cmautner/LED-Cube/Discodelic.png

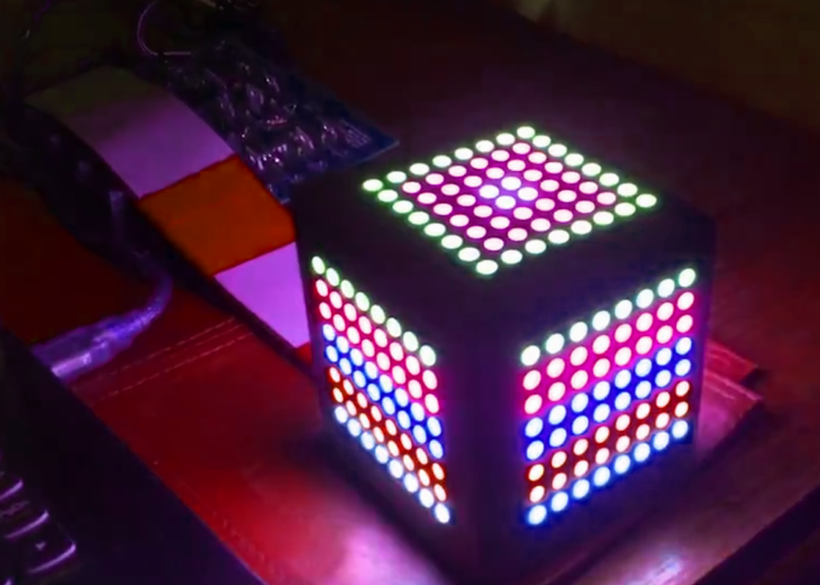
Discodelic.png
