cmautner/LED-Cube/(list of files, drawings)

Other design files:
hardware/LED breakout board.dsn
