cmautner/LED-Cube/hardware/LED breakout board.kicad_pcb

## KiCad design hardware/LED breakout board.kicad_pcb (2016-05-03)

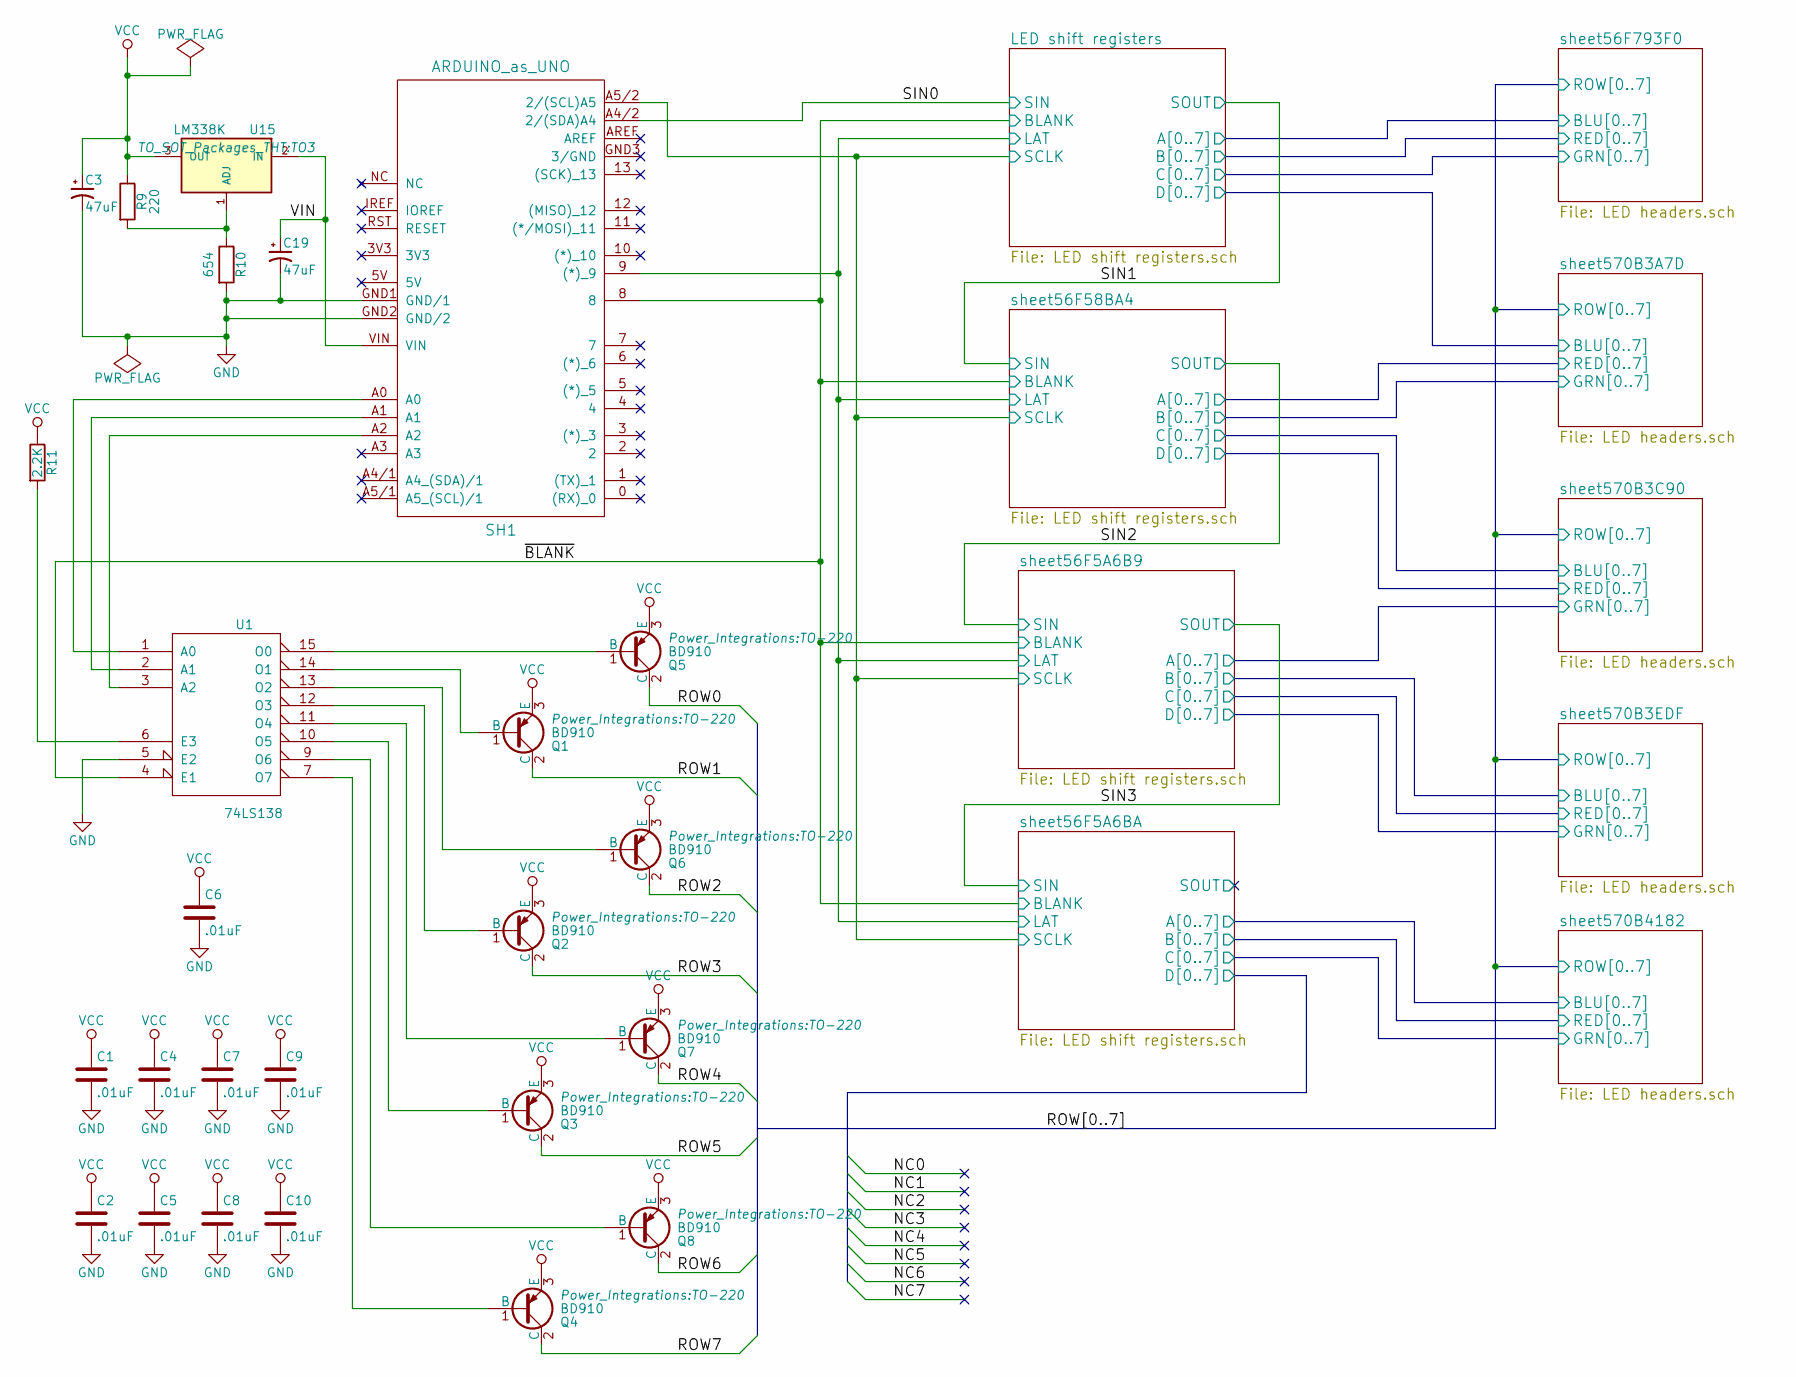
[picture p2: schematic LED breakout board.sch]

Parts:
C1, C2, C4, C5, C6, C7, C8, C9, C10: .01uF; C_Disc_D3_P2.5
C3, C19: 47uF; C_Rect_L7_W3.5_P5
Q1, Q2, Q3, Q4, Q5, Q6, Q7, Q8: BD910; TO-220
R9: 220; Resistor_Horizontal_RM10mm
R10: 654; Resistor_Horizontal_RM10mm
R11: 2.2K; Resistor_Horizontal_RM10mm
SH1: ARDUINO_as_UNO; ARDUINO_as_UNO_R3
U1: 74LS138; DIP-16_W7.62mm
U15: LM338K; TO3

Connections:
/LED shift registers/BLANK: SH1.8, U1.4 (E1); also elsewhere on the board
/LED shift registers/LAT: SH1.9 ((*)_9); also elsewhere on the board
/LED shift registers/SCLK: SH1.A5/2 (2/(SCL)A5); also elsewhere on the board
/LED shift registers/SIN: SH1.A4/2 (2/(SDA)A4); also elsewhere on the board
/ROW0: Q5.2 (C); also elsewhere on the board
/ROW1: Q1.2 (C); also elsewhere on the board
/ROW2: Q6.2 (C); also elsewhere on the board
/ROW3: Q2.2 (C); also elsewhere on the board
/ROW4: Q7.2 (C); also elsewhere on the board
/ROW5: Q3.2 (C); also elsewhere on the board
/ROW6: Q8.2 (C); also elsewhere on the board
/ROW7: Q4.2 (C); also elsewhere on the board
/VIN: C19.1, SH1.VIN, U15.2 (IN)
GND: C1.2, C2.2, C3.2, C4.2, C5.2, C6.2, C7.2, C8.2, C9.2, C10.2, C19.2, R10.2, SH1.GND1 (GND/1), SH1.GND2 (GND/2), U1.5 (E2), U1.8 (GND); also elsewhere on the board
unnamed: Q1.1 (B), U1.14 (O1)
unnamed: Q2.1 (B), U1.12 (O3)
unnamed: Q3.1 (B), U1.10 (O5)
unnamed: Q4.1 (B), U1.7 (O7)
unnamed: Q5.1 (B), U1.15 (O0)
unnamed: Q6.1 (B), U1.13 (O2)
unnamed: Q7.1 (B), U1.11 (O4)
unnamed: Q8.1 (B), U1.9 (O6)
unnamed: R9.2, R10.1, U15.1 (ADJ)
unnamed: R11.2, U1.6 (E3)
unnamed: SH1.A0, U1.1 (A0)
unnamed: SH1.A1, U1.2 (A1)
unnamed: SH1.A2, U1.3 (A2)
VCC: C1.1, C2.1, C3.1, C4.1, C5.1, C6.1, C7.1, C8.1, C9.1, C10.1, Q1.3 (E), Q2.3 (E), Q3.3 (E), Q4.3 (E), Q5.3 (E), Q6.3 (E), Q7.3 (E), Q8.3 (E), R9.1, R11.1, U1.16 (VCC), U15.3 (OUT); also elsewhere on the board

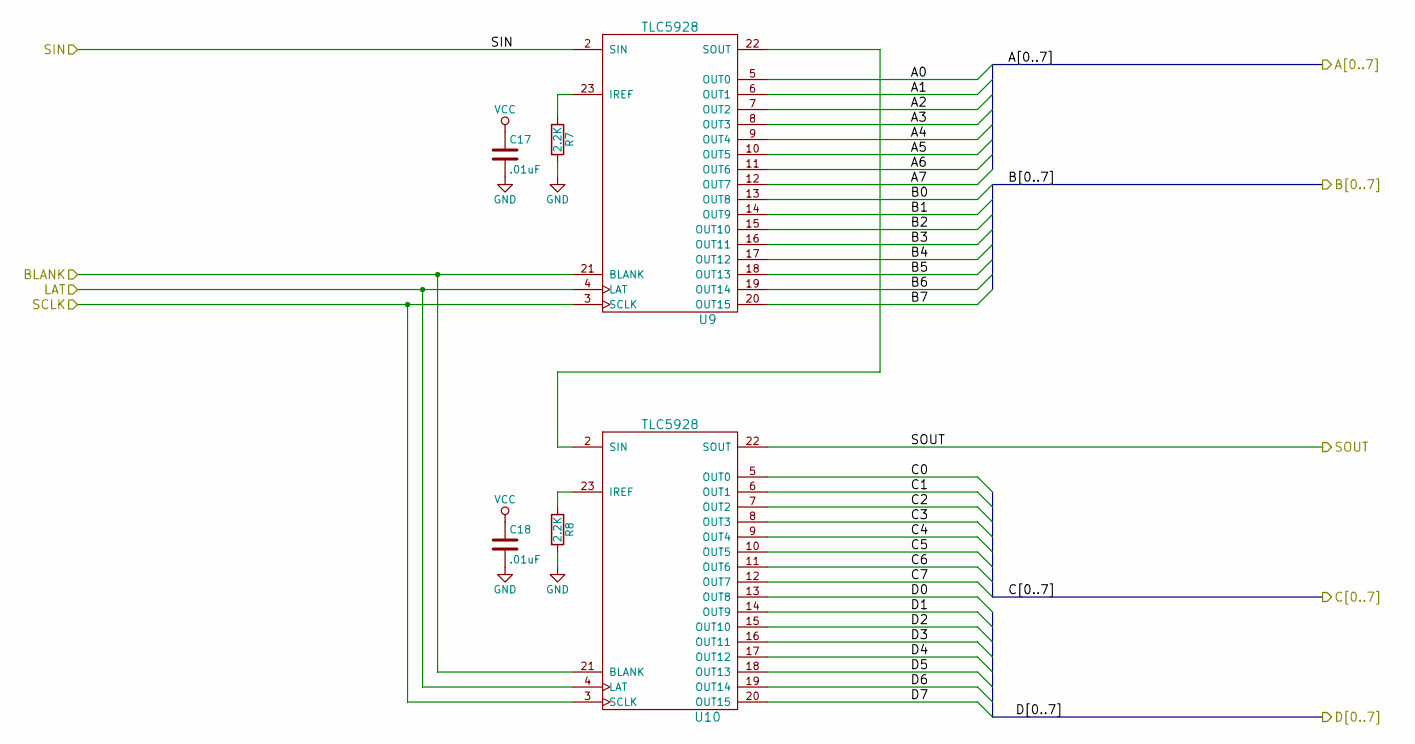
[picture p3: schematic LED shift registers.sch]

Parts:
C11, C12: .01uF; C_Disc_D3_P2.5
R1, R2: 2.2K; Resistor_Horizontal_RM10mm
U2, U3: TLC5928; DIP-24_W7.62mm

Connections:
/LED shift registers/A0: U2.5 (OUT0); also elsewhere on the board
/LED shift registers/A1: U2.6 (OUT1); also elsewhere on the board
/LED shift registers/A2: U2.7 (OUT2); also elsewhere on the board
/LED shift registers/A3: U2.8 (OUT3); also elsewhere on the board
/LED shift registers/A4: U2.9 (OUT4); also elsewhere on the board
/LED shift registers/A5: U2.10 (OUT5); also elsewhere on the board
/LED shift registers/A6: U2.11 (OUT6); also elsewhere on the board
/LED shift registers/A7: U2.12 (OUT7); also elsewhere on the board
/LED shift registers/B0: U2.13 (OUT8); also elsewhere on the board
/LED shift registers/B1: U2.14 (OUT9); also elsewhere on the board
/LED shift registers/B2: U2.15 (OUT10); also elsewhere on the board
/LED shift registers/B3: U2.16 (OUT11); also elsewhere on the board
/LED shift registers/B4: U2.17 (OUT12); also elsewhere on the board
/LED shift registers/B5: U2.18 (OUT13); also elsewhere on the board
/LED shift registers/B6: U2.19 (OUT14); also elsewhere on the board
/LED shift registers/B7: U2.20 (OUT15); also elsewhere on the board
/LED shift registers/BLANK: U2.21 (BLANK), U3.21 (BLANK); also elsewhere on the board
/LED shift registers/C0: U3.5 (OUT0); also elsewhere on the board
/LED shift registers/C1: U3.6 (OUT1); also elsewhere on the board
/LED shift registers/C2: U3.7 (OUT2); also elsewhere on the board
/LED shift registers/C3: U3.8 (OUT3); also elsewhere on the board
/LED shift registers/C4: U3.9 (OUT4); also elsewhere on the board
/LED shift registers/C5: U3.10 (OUT5); also elsewhere on the board
/LED shift registers/C6: U3.11 (OUT6); also elsewhere on the board
/LED shift registers/C7: U3.12 (OUT7); also elsewhere on the board
/LED shift registers/LAT: U2.4 (LAT), U3.4 (LAT); also elsewhere on the board
/LED shift registers/SCLK: U2.3 (SCLK), U3.3 (SCLK); also elsewhere on the board
/LED shift registers/SIN: U2.2 (SIN); also elsewhere on the board
/sheet56F58BA4/SIN: U3.22 (SOUT); also elsewhere on the board
/sheet570B3A7D/BLU0: U3.13 (OUT8); also elsewhere on the board
/sheet570B3A7D/BLU1: U3.14 (OUT9); also elsewhere on the board
/sheet570B3A7D/BLU2: U3.15 (OUT10); also elsewhere on the board
/sheet570B3A7D/BLU3: U3.16 (OUT11); also elsewhere on the board
/sheet570B3A7D/BLU4: U3.17 (OUT12); also elsewhere on the board
/sheet570B3A7D/BLU5: U3.18 (OUT13); also elsewhere on the board
/sheet570B3A7D/BLU6: U3.19 (OUT14); also elsewhere on the board
/sheet570B3A7D/BLU7: U3.20 (OUT15); also elsewhere on the board
GND: C11.2, C12.2, R1.2, R2.2, U2.1 (GND), U3.1 (GND); also elsewhere on the board
unnamed: R1.1, U2.23 (IREF)
unnamed: R2.1, U3.23 (IREF)
unnamed: U2.22 (SOUT), U3.2 (SIN)
VCC: C11.1, C12.1, U2.24 (VCC), U3.24 (VCC); also elsewhere on the board

Parts of its further copies:
C13, C14, C15, C16, C17, C18: .01uF; C_Disc_D3_P2.5
R3, R4, R5, R6, R7, R8: 2.2K; Resistor_Horizontal_RM10mm
U4, U5, U6, U7, U9, U10: TLC5928; DIP-24_W7.62mm

Connections of its further copies:
/LED shift registers/BLANK: U4.21 (BLANK), U5.21 (BLANK), U6.21 (BLANK), U7.21 (BLANK), U9.21 (BLANK), U10.21 (BLANK); also elsewhere on the board
/LED shift registers/LAT: U4.4 (LAT), U5.4 (LAT), U6.4 (LAT), U7.4 (LAT), U9.4 (LAT), U10.4 (LAT); also elsewhere on the board
/LED shift registers/SCLK: U4.3 (SCLK), U5.3 (SCLK), U6.3 (SCLK), U7.3 (SCLK), U9.3 (SCLK), U10.3 (SCLK); also elsewhere on the board
/sheet56F5A6B9/A0: U4.5 (OUT0); also elsewhere on the board
/sheet56F5A6B9/A1: U4.6 (OUT1); also elsewhere on the board
/sheet56F5A6B9/A2: U4.7 (OUT2); also elsewhere on the board
/sheet56F5A6B9/A3: U4.8 (OUT3); also elsewhere on the board
/sheet56F5A6B9/A4: U4.9 (OUT4); also elsewhere on the board
/sheet56F5A6B9/A5: U4.10 (OUT5); also elsewhere on the board
/sheet56F5A6B9/A6: U4.11 (OUT6); also elsewhere on the board
/sheet56F5A6B9/A7: U4.12 (OUT7); also elsewhere on the board
/sheet56F5A6B9/B0: U4.13 (OUT8); also elsewhere on the board
/sheet56F5A6B9/B1: U4.14 (OUT9); also elsewhere on the board
/sheet56F5A6B9/B2: U4.15 (OUT10); also elsewhere on the board
/sheet56F5A6B9/B3: U4.16 (OUT11); also elsewhere on the board
/sheet56F5A6B9/B4: U4.17 (OUT12); also elsewhere on the board
/sheet56F5A6B9/B5: U4.18 (OUT13); also elsewhere on the board
/sheet56F5A6B9/B6: U4.19 (OUT14); also elsewhere on the board
/sheet56F5A6B9/B7: U4.20 (OUT15); also elsewhere on the board
/sheet56F5A6B9/C0: U5.5 (OUT0); also elsewhere on the board
/sheet56F5A6B9/C1: U5.6 (OUT1); also elsewhere on the board
/sheet56F5A6B9/C2: U5.7 (OUT2); also elsewhere on the board
/sheet56F5A6B9/C3: U5.8 (OUT3); also elsewhere on the board
/sheet56F5A6B9/C4: U5.9 (OUT4); also elsewhere on the board
/sheet56F5A6B9/C5: U5.10 (OUT5); also elsewhere on the board
/sheet56F5A6B9/C6: U5.11 (OUT6); also elsewhere on the board
/sheet56F5A6B9/C7: U5.12 (OUT7); also elsewhere on the board
/sheet56F5A6B9/D0: U5.13 (OUT8); also elsewhere on the board
/sheet56F5A6B9/D1: U5.14 (OUT9); also elsewhere on the board
/sheet56F5A6B9/D2: U5.15 (OUT10); also elsewhere on the board
/sheet56F5A6B9/D3: U5.16 (OUT11); also elsewhere on the board
/sheet56F5A6B9/D4: U5.17 (OUT12); also elsewhere on the board
/sheet56F5A6B9/D5: U5.18 (OUT13); also elsewhere on the board
/sheet56F5A6B9/D6: U5.19 (OUT14); also elsewhere on the board
/sheet56F5A6B9/D7: U5.20 (OUT15); also elsewhere on the board
/sheet56F5A6B9/SIN: U4.2 (SIN), U10.22 (SOUT)
/sheet56F5A6BA/A0: U6.5 (OUT0); also elsewhere on the board
/sheet56F5A6BA/A1: U6.6 (OUT1); also elsewhere on the board
/sheet56F5A6BA/A2: U6.7 (OUT2); also elsewhere on the board
/sheet56F5A6BA/A3: U6.8 (OUT3); also elsewhere on the board
/sheet56F5A6BA/A4: U6.9 (OUT4); also elsewhere on the board
/sheet56F5A6BA/A5: U6.10 (OUT5); also elsewhere on the board
/sheet56F5A6BA/A6: U6.11 (OUT6); also elsewhere on the board
/sheet56F5A6BA/A7: U6.12 (OUT7); also elsewhere on the board
/sheet56F5A6BA/B0: U6.13 (OUT8); also elsewhere on the board
/sheet56F5A6BA/B1: U6.14 (OUT9); also elsewhere on the board
/sheet56F5A6BA/B2: U6.15 (OUT10); also elsewhere on the board
/sheet56F5A6BA/B3: U6.16 (OUT11); also elsewhere on the board
/sheet56F5A6BA/B4: U6.17 (OUT12); also elsewhere on the board
/sheet56F5A6BA/B5: U6.18 (OUT13); also elsewhere on the board
/sheet56F5A6BA/B6: U6.19 (OUT14); also elsewhere on the board
/sheet56F5A6BA/B7: U6.20 (OUT15); also elsewhere on the board
/sheet56F5A6BA/C0: U7.5 (OUT0); also elsewhere on the board
/sheet56F5A6BA/C1: U7.6 (OUT1); also elsewhere on the board
/sheet56F5A6BA/C2: U7.7 (OUT2); also elsewhere on the board
/sheet56F5A6BA/C3: U7.8 (OUT3); also elsewhere on the board
/sheet56F5A6BA/C4: U7.9 (OUT4); also elsewhere on the board
/sheet56F5A6BA/C5: U7.10 (OUT5); also elsewhere on the board
/sheet56F5A6BA/C6: U7.11 (OUT6); also elsewhere on the board
/sheet56F5A6BA/C7: U7.12 (OUT7); also elsewhere on the board
/sheet56F5A6BA/SIN: U5.22 (SOUT), U6.2 (SIN)
/sheet56F58BA4/A0: U9.5 (OUT0); also elsewhere on the board
/sheet56F58BA4/A1: U9.6 (OUT1); also elsewhere on the board
/sheet56F58BA4/A2: U9.7 (OUT2); also elsewhere on the board
/sheet56F58BA4/A3: U9.8 (OUT3); also elsewhere on the board
/sheet56F58BA4/A4: U9.9 (OUT4); also elsewhere on the board
/sheet56F58BA4/A5: U9.10 (OUT5); also elsewhere on the board
/sheet56F58BA4/A6: U9.11 (OUT6); also elsewhere on the board
/sheet56F58BA4/A7: U9.12 (OUT7); also elsewhere on the board
/sheet56F58BA4/B0: U9.13 (OUT8); also elsewhere on the board
/sheet56F58BA4/B1: U9.14 (OUT9); also elsewhere on the board
/sheet56F58BA4/B2: U9.15 (OUT10); also elsewhere on the board
/sheet56F58BA4/B3: U9.16 (OUT11); also elsewhere on the board
/sheet56F58BA4/B4: U9.17 (OUT12); also elsewhere on the board
/sheet56F58BA4/B5: U9.18 (OUT13); also elsewhere on the board
/sheet56F58BA4/B6: U9.19 (OUT14); also elsewhere on the board
/sheet56F58BA4/B7: U9.20 (OUT15); also elsewhere on the board
/sheet56F58BA4/D0: U10.13 (OUT8); also elsewhere on the board
/sheet56F58BA4/D1: U10.14 (OUT9); also elsewhere on the board
/sheet56F58BA4/D2: U10.15 (OUT10); also elsewhere on the board
/sheet56F58BA4/D3: U10.16 (OUT11); also elsewhere on the board
/sheet56F58BA4/D4: U10.17 (OUT12); also elsewhere on the board
/sheet56F58BA4/D5: U10.18 (OUT13); also elsewhere on the board
/sheet56F58BA4/D6: U10.19 (OUT14); also elsewhere on the board
/sheet56F58BA4/D7: U10.20 (OUT15); also elsewhere on the board
/sheet56F58BA4/SIN: U9.2 (SIN); also elsewhere on the board
/sheet570B3C90/BLU0: U10.5 (OUT0); also elsewhere on the board
/sheet570B3C90/BLU1: U10.6 (OUT1); also elsewhere on the board
/sheet570B3C90/BLU2: U10.7 (OUT2); also elsewhere on the board
/sheet570B3C90/BLU3: U10.8 (OUT3); also elsewhere on the board
/sheet570B3C90/BLU4: U10.9 (OUT4); also elsewhere on the board
/sheet570B3C90/BLU5: U10.10 (OUT5); also elsewhere on the board
/sheet570B3C90/BLU6: U10.11 (OUT6); also elsewhere on the board
/sheet570B3C90/BLU7: U10.12 (OUT7); also elsewhere on the board
GND: C13.2, C14.2, C15.2, C16.2, C17.2, C18.2, R3.2, R4.2, R5.2, R6.2, R7.2, R8.2, U4.1 (GND), U5.1 (GND), U6.1 (GND), U7.1 (GND), U9.1 (GND), U10.1 (GND); also elsewhere on the board
unnamed: R3.1, U4.23 (IREF)
unnamed: R4.1, U5.23 (IREF)
unnamed: R5.1, U6.23 (IREF)
unnamed: R6.1, U7.23 (IREF)
unnamed: R7.1, U9.23 (IREF)
unnamed: R8.1, U10.23 (IREF)
unnamed: U4.22 (SOUT), U5.2 (SIN)
unnamed: U6.22 (SOUT), U7.2 (SIN)
unnamed: U9.22 (SOUT), U10.2 (SIN)
VCC: C13.1, C14.1, C15.1, C16.1, C17.1, C18.1, U4.24 (VCC), U5.24 (VCC), U6.24 (VCC), U7.24 (VCC), U9.24 (VCC), U10.24 (VCC); also elsewhere on the board

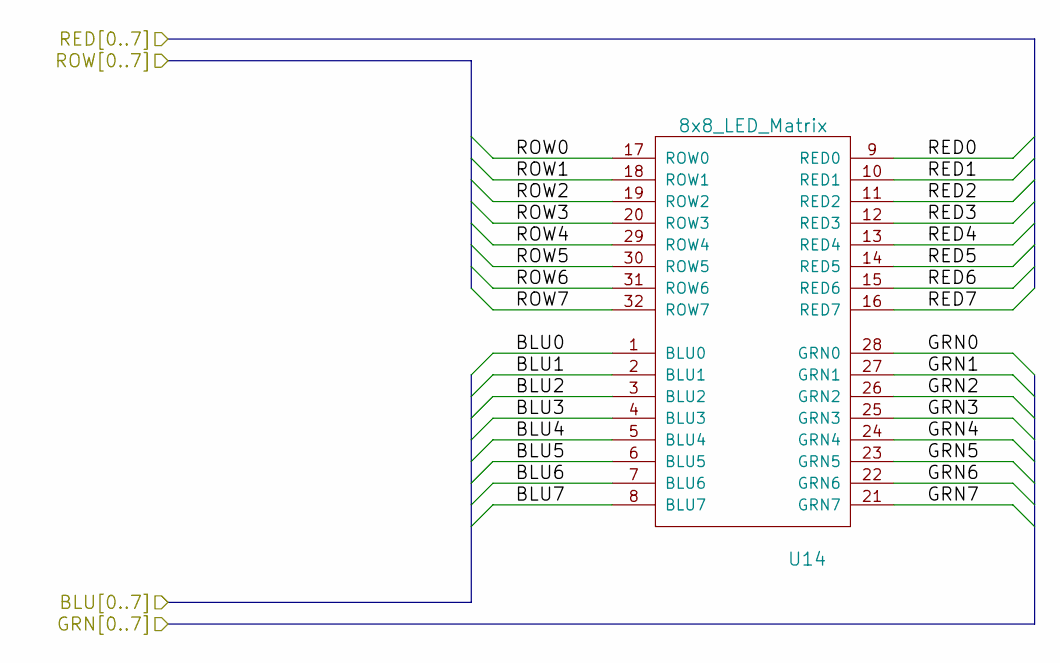
[picture p4: schematic LED headers.sch]

Parts:
U8: 8x8_LED_Matrix

Connections:
/LED shift registers/A0: U8.1 (BLU0); also elsewhere on the board
/LED shift registers/A1: U8.2 (BLU1); also elsewhere on the board
/LED shift registers/A2: U8.3 (BLU2); also elsewhere on the board
/LED shift registers/A3: U8.4 (BLU3); also elsewhere on the board
/LED shift registers/A4: U8.5 (BLU4); also elsewhere on the board
/LED shift registers/A5: U8.6 (BLU5); also elsewhere on the board
/LED shift registers/A6: U8.7 (BLU6); also elsewhere on the board
/LED shift registers/A7: U8.8 (BLU7); also elsewhere on the board
/LED shift registers/B0: U8.9 (RED0); also elsewhere on the board
/LED shift registers/B1: U8.10 (RED1); also elsewhere on the board
/LED shift registers/B2: U8.11 (RED2); also elsewhere on the board
/LED shift registers/B3: U8.12 (RED3); also elsewhere on the board
/LED shift registers/B4: U8.13 (RED4); also elsewhere on the board
/LED shift registers/B5: U8.14 (RED5); also elsewhere on the board
/LED shift registers/B6: U8.15 (RED6); also elsewhere on the board
/LED shift registers/B7: U8.16 (RED7); also elsewhere on the board
/LED shift registers/C0: U8.28 (GRN0); also elsewhere on the board
/LED shift registers/C1: U8.27 (GRN1); also elsewhere on the board
/LED shift registers/C2: U8.26 (GRN2); also elsewhere on the board
/LED shift registers/C3: U8.25 (GRN3); also elsewhere on the board
/LED shift registers/C4: U8.24 (GRN4); also elsewhere on the board
/LED shift registers/C5: U8.23 (GRN5); also elsewhere on the board
/LED shift registers/C6: U8.22 (GRN6); also elsewhere on the board
/LED shift registers/C7: U8.21 (GRN7); also elsewhere on the board
/ROW0: U8.17 (ROW0); also elsewhere on the board
/ROW1: U8.18 (ROW1); also elsewhere on the board
/ROW2: U8.19 (ROW2); also elsewhere on the board
/ROW3: U8.20 (ROW3); also elsewhere on the board
/ROW4: U8.29 (ROW4); also elsewhere on the board
/ROW5: U8.30 (ROW5); also elsewhere on the board
/ROW6: U8.31 (ROW6); also elsewhere on the board
/ROW7: U8.32 (ROW7); also elsewhere on the board

Parts of its further copies:
U11, U12, U13, U14: 8x8_LED_Matrix

Connections of its further copies:
/ROW0: U11.17 (ROW0), U12.17 (ROW0), U13.17 (ROW0), U14.17 (ROW0); also elsewhere on the board
/ROW1: U11.18 (ROW1), U12.18 (ROW1), U13.18 (ROW1), U14.18 (ROW1); also elsewhere on the board
/ROW2: U11.19 (ROW2), U12.19 (ROW2), U13.19 (ROW2), U14.19 (ROW2); also elsewhere on the board
/ROW3: U11.20 (ROW3), U12.20 (ROW3), U13.20 (ROW3), U14.20 (ROW3); also elsewhere on the board
/ROW4: U11.29 (ROW4), U12.29 (ROW4), U13.29 (ROW4), U14.29 (ROW4); also elsewhere on the board
/ROW5: U11.30 (ROW5), U12.30 (ROW5), U13.30 (ROW5), U14.30 (ROW5); also elsewhere on the board
/ROW6: U11.31 (ROW6), U12.31 (ROW6), U13.31 (ROW6), U14.31 (ROW6); also elsewhere on the board
/ROW7: U11.32 (ROW7), U12.32 (ROW7), U13.32 (ROW7), U14.32 (ROW7); also elsewhere on the board
/sheet56F5A6B9/A0: U12.28 (GRN0); also elsewhere on the board
/sheet56F5A6B9/A1: U12.27 (GRN1); also elsewhere on the board
/sheet56F5A6B9/A2: U12.26 (GRN2); also elsewhere on the board
/sheet56F5A6B9/A3: U12.25 (GRN3); also elsewhere on the board
/sheet56F5A6B9/A4: U12.24 (GRN4); also elsewhere on the board
/sheet56F5A6B9/A5: U12.23 (GRN5); also elsewhere on the board
/sheet56F5A6B9/A6: U12.22 (GRN6); also elsewhere on the board
/sheet56F5A6B9/A7: U12.21 (GRN7); also elsewhere on the board
/sheet56F5A6B9/B0: U13.1 (BLU0); also elsewhere on the board
/sheet56F5A6B9/B1: U13.2 (BLU1); also elsewhere on the board
/sheet56F5A6B9/B2: U13.3 (BLU2); also elsewhere on the board
/sheet56F5A6B9/B3: U13.4 (BLU3); also elsewhere on the board
/sheet56F5A6B9/B4: U13.5 (BLU4); also elsewhere on the board
/sheet56F5A6B9/B5: U13.6 (BLU5); also elsewhere on the board
/sheet56F5A6B9/B6: U13.7 (BLU6); also elsewhere on the board
/sheet56F5A6B9/B7: U13.8 (BLU7); also elsewhere on the board
/sheet56F5A6B9/C0: U13.9 (RED0); also elsewhere on the board
/sheet56F5A6B9/C1: U13.10 (RED1); also elsewhere on the board
/sheet56F5A6B9/C2: U13.11 (RED2); also elsewhere on the board
/sheet56F5A6B9/C3: U13.12 (RED3); also elsewhere on the board
/sheet56F5A6B9/C4: U13.13 (RED4); also elsewhere on the board
/sheet56F5A6B9/C5: U13.14 (RED5); also elsewhere on the board
/sheet56F5A6B9/C6: U13.15 (RED6); also elsewhere on the board
/sheet56F5A6B9/C7: U13.16 (RED7); also elsewhere on the board
/sheet56F5A6B9/D0: U13.28 (GRN0); also elsewhere on the board
/sheet56F5A6B9/D1: U13.27 (GRN1); also elsewhere on the board
/sheet56F5A6B9/D2: U13.26 (GRN2); also elsewhere on the board
/sheet56F5A6B9/D3: U13.25 (GRN3); also elsewhere on the board
/sheet56F5A6B9/D4: U13.24 (GRN4); also elsewhere on the board
/sheet56F5A6B9/D5: U13.23 (GRN5); also elsewhere on the board
/sheet56F5A6B9/D6: U13.22 (GRN6); also elsewhere on the board
/sheet56F5A6B9/D7: U13.21 (GRN7); also elsewhere on the board
/sheet56F5A6BA/A0: U14.1 (BLU0); also elsewhere on the board
/sheet56F5A6BA/A1: U14.2 (BLU1); also elsewhere on the board
/sheet56F5A6BA/A2: U14.3 (BLU2); also elsewhere on the board
/sheet56F5A6BA/A3: U14.4 (BLU3); also elsewhere on the board
/sheet56F5A6BA/A4: U14.5 (BLU4); also elsewhere on the board
/sheet56F5A6BA/A5: U14.6 (BLU5); also elsewhere on the board
/sheet56F5A6BA/A6: U14.7 (BLU6); also elsewhere on the board
/sheet56F5A6BA/A7: U14.8 (BLU7); also elsewhere on the board
/sheet56F5A6BA/B0: U14.9 (RED0); also elsewhere on the board
/sheet56F5A6BA/B1: U14.10 (RED1); also elsewhere on the board
/sheet56F5A6BA/B2: U14.11 (RED2); also elsewhere on the board
/sheet56F5A6BA/B3: U14.12 (RED3); also elsewhere on the board
/sheet56F5A6BA/B4: U14.13 (RED4); also elsewhere on the board
/sheet56F5A6BA/B5: U14.14 (RED5); also elsewhere on the board
/sheet56F5A6BA/B6: U14.15 (RED6); also elsewhere on the board
/sheet56F5A6BA/B7: U14.16 (RED7); also elsewhere on the board
/sheet56F5A6BA/C0: U14.28 (GRN0); also elsewhere on the board
/sheet56F5A6BA/C1: U14.27 (GRN1); also elsewhere on the board
/sheet56F5A6BA/C2: U14.26 (GRN2); also elsewhere on the board
/sheet56F5A6BA/C3: U14.25 (GRN3); also elsewhere on the board
/sheet56F5A6BA/C4: U14.24 (GRN4); also elsewhere on the board
/sheet56F5A6BA/C5: U14.23 (GRN5); also elsewhere on the board
/sheet56F5A6BA/C6: U14.22 (GRN6); also elsewhere on the board
/sheet56F5A6BA/C7: U14.21 (GRN7); also elsewhere on the board
/sheet56F58BA4/A0: U11.9 (RED0); also elsewhere on the board
/sheet56F58BA4/A1: U11.10 (RED1); also elsewhere on the board
/sheet56F58BA4/A2: U11.11 (RED2); also elsewhere on the board
/sheet56F58BA4/A3: U11.12 (RED3); also elsewhere on the board
/sheet56F58BA4/A4: U11.13 (RED4); also elsewhere on the board
/sheet56F58BA4/A5: U11.14 (RED5); also elsewhere on the board
/sheet56F58BA4/A6: U11.15 (RED6); also elsewhere on the board
/sheet56F58BA4/A7: U11.16 (RED7); also elsewhere on the board
/sheet56F58BA4/B0: U11.28 (GRN0); also elsewhere on the board
/sheet56F58BA4/B1: U11.27 (GRN1); also elsewhere on the board
/sheet56F58BA4/B2: U11.26 (GRN2); also elsewhere on the board
/sheet56F58BA4/B3: U11.25 (GRN3); also elsewhere on the board
/sheet56F58BA4/B4: U11.24 (GRN4); also elsewhere on the board
/sheet56F58BA4/B5: U11.23 (GRN5); also elsewhere on the board
/sheet56F58BA4/B6: U11.22 (GRN6); also elsewhere on the board
/sheet56F58BA4/B7: U11.21 (GRN7); also elsewhere on the board
/sheet56F58BA4/D0: U12.9 (RED0); also elsewhere on the board
/sheet56F58BA4/D1: U12.10 (RED1); also elsewhere on the board
/sheet56F58BA4/D2: U12.11 (RED2); also elsewhere on the board
/sheet56F58BA4/D3: U12.12 (RED3); also elsewhere on the board
/sheet56F58BA4/D4: U12.13 (RED4); also elsewhere on the board
/sheet56F58BA4/D5: U12.14 (RED5); also elsewhere on the board
/sheet56F58BA4/D6: U12.15 (RED6); also elsewhere on the board
/sheet56F58BA4/D7: U12.16 (RED7); also elsewhere on the board
/sheet570B3A7D/BLU0: U11.1 (BLU0); also elsewhere on the board
/sheet570B3A7D/BLU1: U11.2 (BLU1); also elsewhere on the board
/sheet570B3A7D/BLU2: U11.3 (BLU2); also elsewhere on the board
/sheet570B3A7D/BLU3: U11.4 (BLU3); also elsewhere on the board
/sheet570B3A7D/BLU4: U11.5 (BLU4); also elsewhere on the board
/sheet570B3A7D/BLU5: U11.6 (BLU5); also elsewhere on the board
/sheet570B3A7D/BLU6: U11.7 (BLU6); also elsewhere on the board
/sheet570B3A7D/BLU7: U11.8 (BLU7); also elsewhere on the board
/sheet570B3C90/BLU0: U12.1 (BLU0); also elsewhere on the board
/sheet570B3C90/BLU1: U12.2 (BLU1); also elsewhere on the board
/sheet570B3C90/BLU2: U12.3 (BLU2); also elsewhere on the board
/sheet570B3C90/BLU3: U12.4 (BLU3); also elsewhere on the board
/sheet570B3C90/BLU4: U12.5 (BLU4); also elsewhere on the board
/sheet570B3C90/BLU5: U12.6 (BLU5); also elsewhere on the board
/sheet570B3C90/BLU6: U12.7 (BLU6); also elsewhere on the board
/sheet570B3C90/BLU7: U12.8 (BLU7); also elsewhere on the board

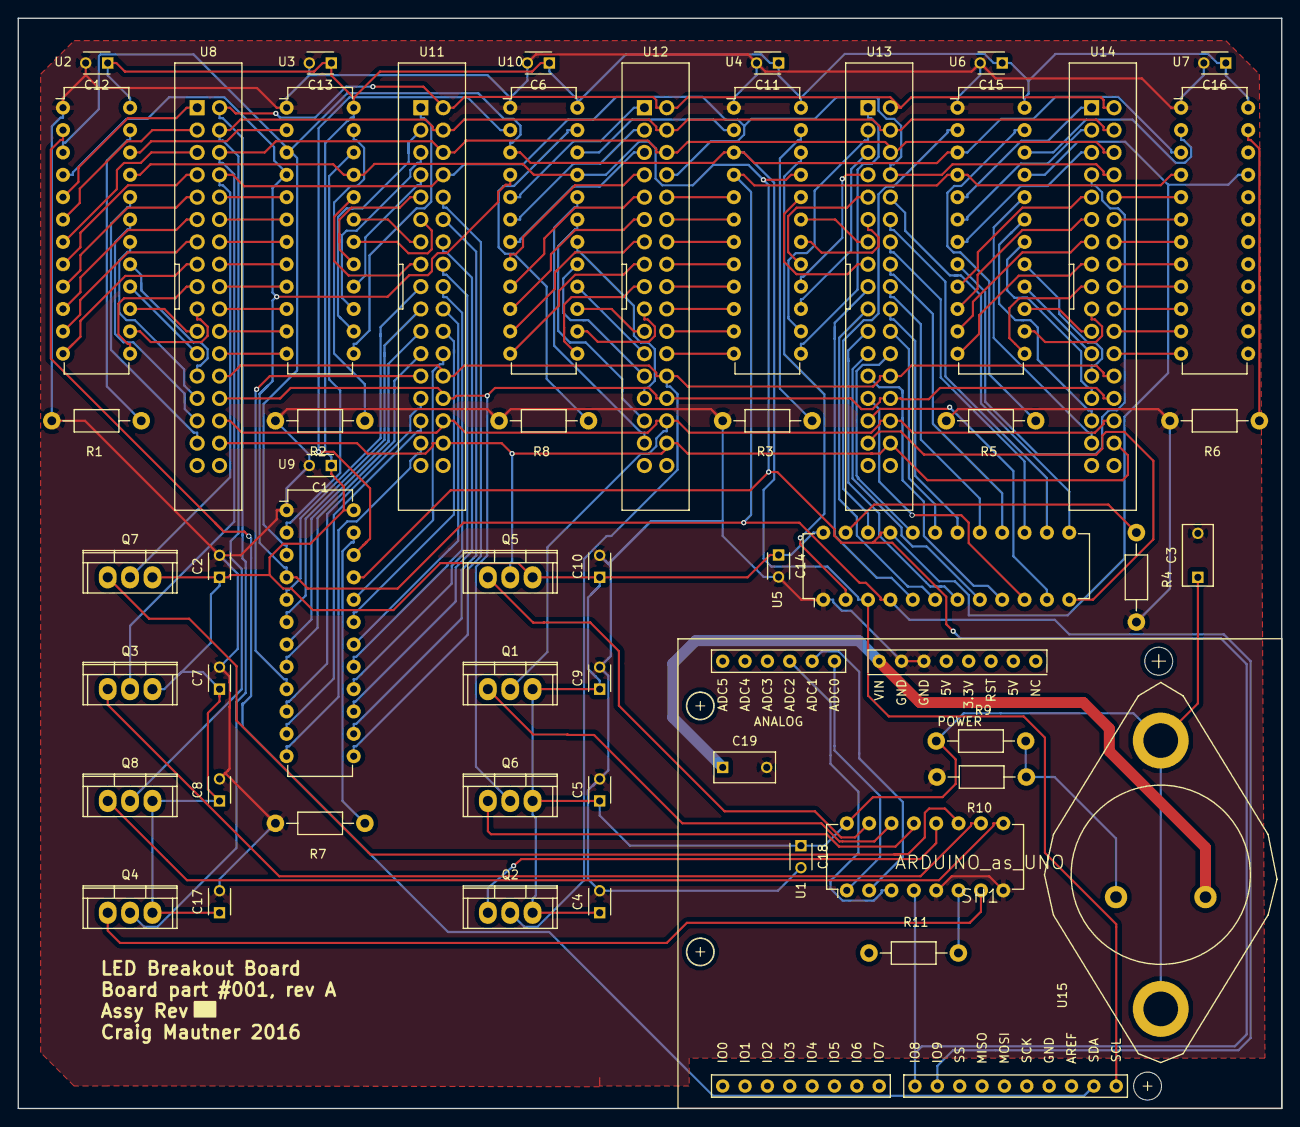
[picture p5: board LED breakout board.kicad_pcb from above]

Board: 2 copper layers, 143.5 x 123.8 mm, 54 parts (0 on the bottom side), 163 nets.
