cmautner/LED-Cube/src/Waterfall/Waterfall.ino

#include <TimerOne.h>
#include <DiscodelicLib.h>
#include "Animate.h"

void setup() {
  Serial.begin(115200);

  randomSeed(analogRead(0));

  Discodelic1.setup();
  Discodelic1.dumpAllPanels();

  // 40 msec close to 24 frames/sec
  Discodelic::registerCallback(40000, animate);
}

void loop() {
  Discodelic1.refresh();
}
