cmautner/LED-Cube/(commit log)

2016-05-03 Adding first files
    I believe these are the basic files needed to create and program the
    board. I will add the docs next
    [LED breakout board.kicad_pcb, LED breakout board.sch, LED headers.sch, LED shift registers.sch]
2016-05-10 Speed up refresh
    The data line is now changed when the clock line falls. That saves one
    cycle but means that the clock line must be high when CLOCK_DATA() is
    called.
    The BLANK_ signal is now LOW all the time.
    The LED pattern is a little more interesting. Red brightens, Green
    fades, blue brightens.
    The dimness pattern is updated to spread across the entire cycle instead
    of being bursty up front. Using a lookup table.
2016-06-19 Rows and LEDs updating correctly
    At last!
    [LED breakout board.csv, LED breakout board.dsn, LED headers - Copy.sch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]
2016-06-20 Revert "Not working but want to save this before I revert"
    This reverts commit ac0a81957a16fac9b56a452baf793fa43df07653.
    [TimerInterrupt.cpp]
2016-06-20 Renamed TimerInterrupt to Refresh
2016-06-25 Added user input, cleaned up loop timing, new pattern
    Added the ability to read IO7 pin to allow the pattern to change.
    Changed the timing to be able to be used for larger cycles than 6.
    Added a modified waterfall pattern that gradually changes the color.
2016-06-28 Switch to DiscodelicLib library
    Move common code into Arduino library.
2016-07-10 Remove predictability
    Color changes were in sync with panel changes so the patterns
    weren't changing as often as they were intended.
    Also cleaned up the timing to let the interrupt drive the animation
    rather than dividing down the interrupt.
2017-03-07 Got Hello World printing on all 5 panels. Either scrolling or static. Working with the latest Discodelic library.
2017-03-11 Fixed all of the wide panel problems. Renamed LED_board app to Waterfall.
    [Animate.cpp, Waterfall.ino, WideHelloWorld.ino]
2017-03-15 Converted over to new library form where the library takes care of the interrupt timer and turning off and on the LEDs while rendering.
2017-03-18 First cut at a snake game. Self playing. Next cut to be greedy as it aims for food.
2017-03-21 Fixed all bugs related to moving in bad direction. Set up auto play. Fixed colors.
    [Snake1.ino]
2017-03-21 Random was resetting the seed to the same few combinations every time. Adding in micros() after each death makes it more random. The real solution is to extract the reset from setup().
    [Snake1.ino]
2017-04-08 Added debug which tracked down the problem with fireworks that start on the top and span a corner end up on two sides of the top. Fixed by starting all fireworks on the sides.
    [Fireworks1.ino]
